kebundsc/solar_thermal_system/Doku/finalsolution.jpeg

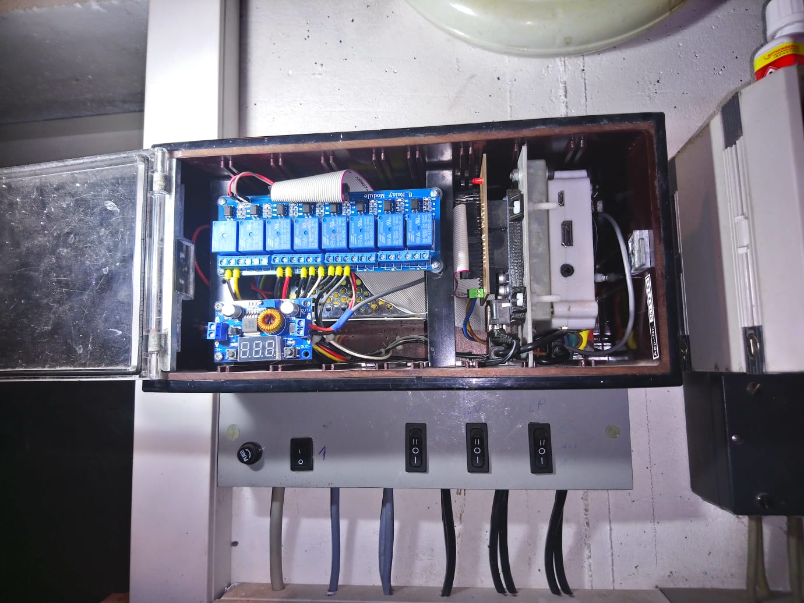
Doku/finalsolution.jpeg
