kebundsc/solar_thermal_system/ArduinoUNO/arduinoshield.jpeg

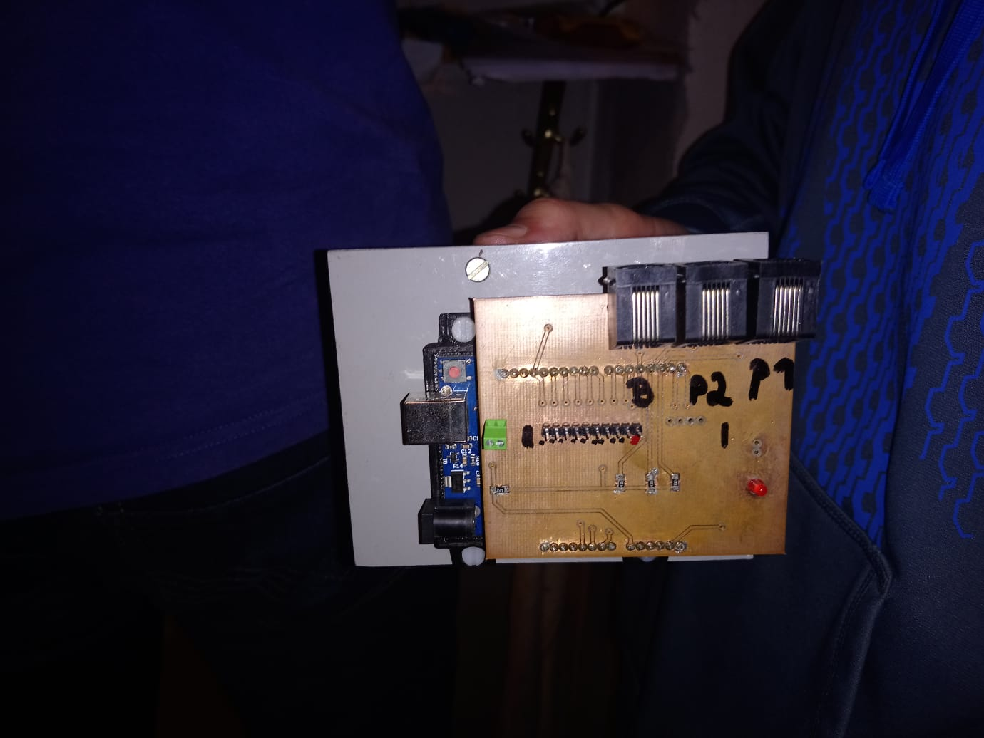
ArduinoUNO/arduinoshield.jpeg
