kebundsc/solar_thermal_system/Doku/solarthermalsystem_2018_19_MoCo.pdf

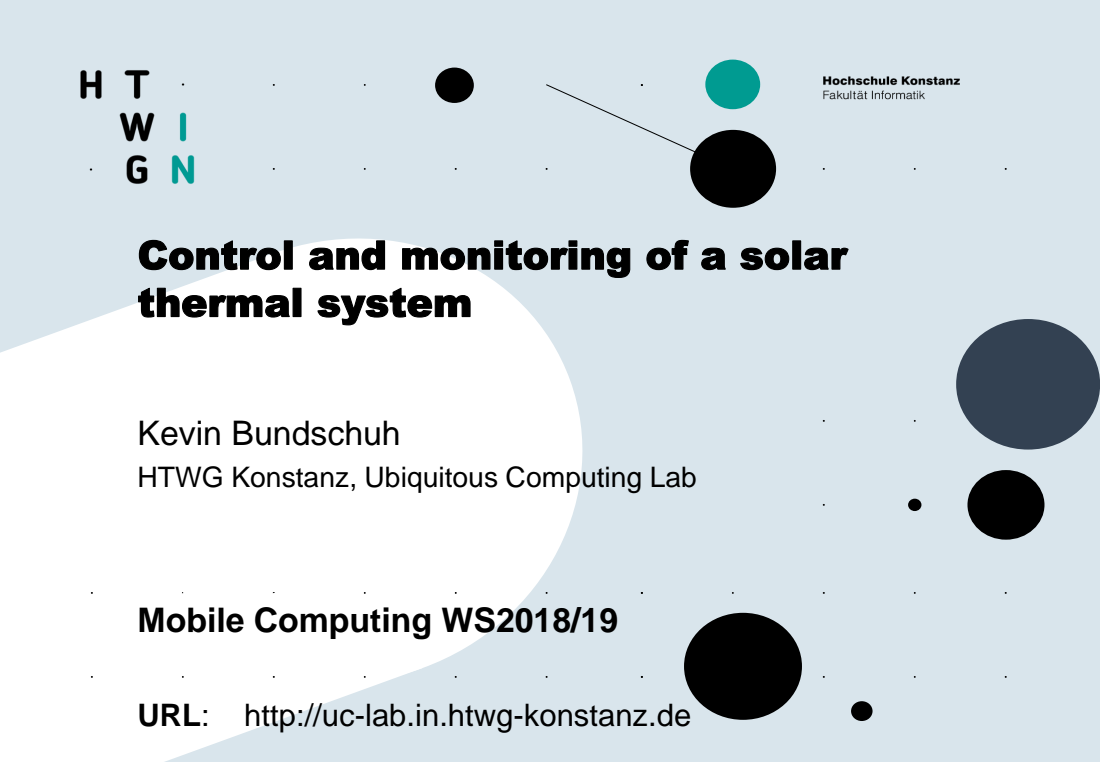
[picture p7: page 1]

Control and monitoring of a solar
thermal system

Kevin Bundschuh
HTWG Konstanz, Ubiquitous Computing Lab

Prof. Dr. Ralf E.D. Seepold
Mobile Computing WS2018/19

URL: http://uc-lab.in.htwg-konstanz.de

## Table of contents

- Introduction
- Project Targets
- Control Unit
- Hardware
- Software
- Monitoring System
- Final Solution
- Conclusion future Work
© Prof. Dr. Ralf E.D. Seepold | Ubiquitous Computing Lab | 2

## Introduction

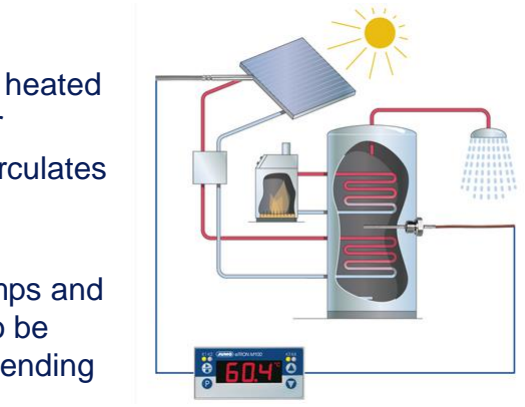
[picture p8: figure]

⚫ | Carrier fluid is heated up in Collector
⚫ | Carrier fluid circulates trough heat exchangers
⚫ | Therefore pumps and valves need to be controlled depending on meassured temperatures

http://www.jumo.nl/nl_NL/branches/Duurzame-energie/toepassingen/thermische-zonne-energie/solarthermie.html

## Project Targets


⚫ | Control Unit
| • reliable • low cost • easy to maintain
⚫ | Monitoring
| • Real time data • Data Archive • Compatibe with many different devices

## Control Unit → Hardware

- Arduino uno
- 8-Way Relais Module
- 6 x DS18B20 temperature sensors (1Wire)
- 1 x PT 1500 temperature sensor

0,65

0,7

0,75

0,8

0,85

0,9

0,95

1000 1100 1200 1300 1400 1500 1600 1700 1800 1900 2000 2100 2200 2300 2400 2500 2600 2700 2800 2900 3000

resistance

resistance

## Control Unit → Hardware

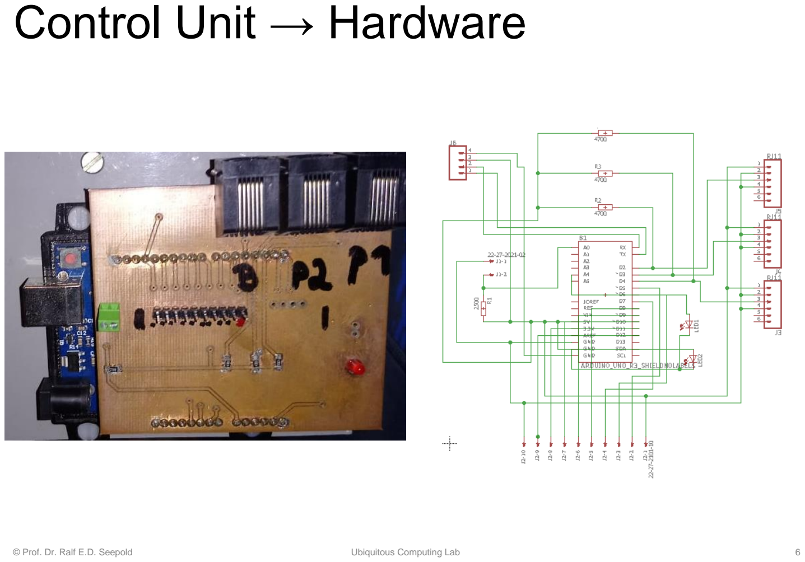
[picture p9: page 6]

## Control Unit → Software

- Arduino *.ino sketch
- Reading temperatures from 1Wire devices
- Calculating temperature from PTC
- Controling relais module via GPIOs
- Watchdog timer to increase reliablity
- Providing data over serial port

0

500

1000

1500

2000

2500

3000

3500

4000

0 | 10 | 20 | 25 | 30 | 40 | 50 | 60 | 70 | 80 | 90 | 100
Datenreihen1 | linear

r(x) = 18.74x + 1630

## Monitoring System → Architecture


⚫ | Software runing on the Raspberry PI
⚫ | Managing real time data and data archive

## Monitoring System → AMQP Broker

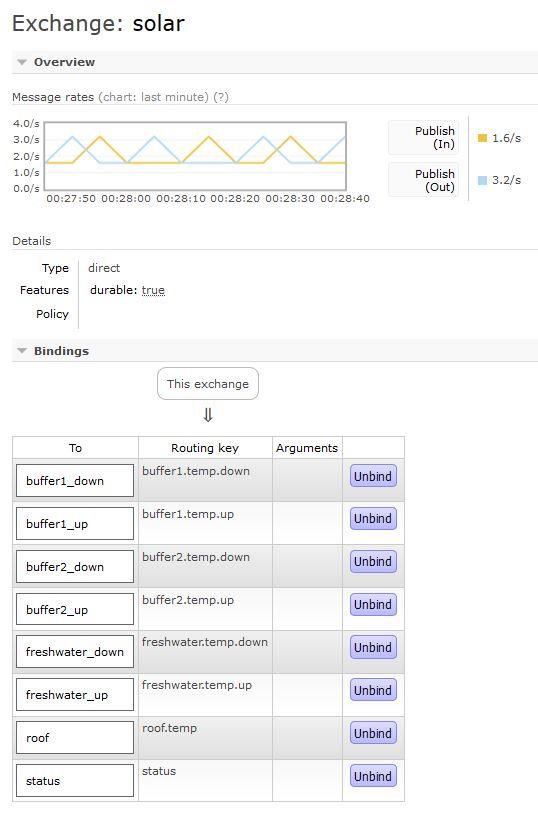
[picture p10: figure]

⚫ | Exchange has multiple bindigs to certain queues
⚫ | One queue for each temperature value and current status of the system

## Monitoring System → Node RED

- Is a programming tool for wiring together hardware devices, APIs and online services
- The runtime is built on Node.js
- Nodes for a live data dashboard

## Monitoring System → Node RED

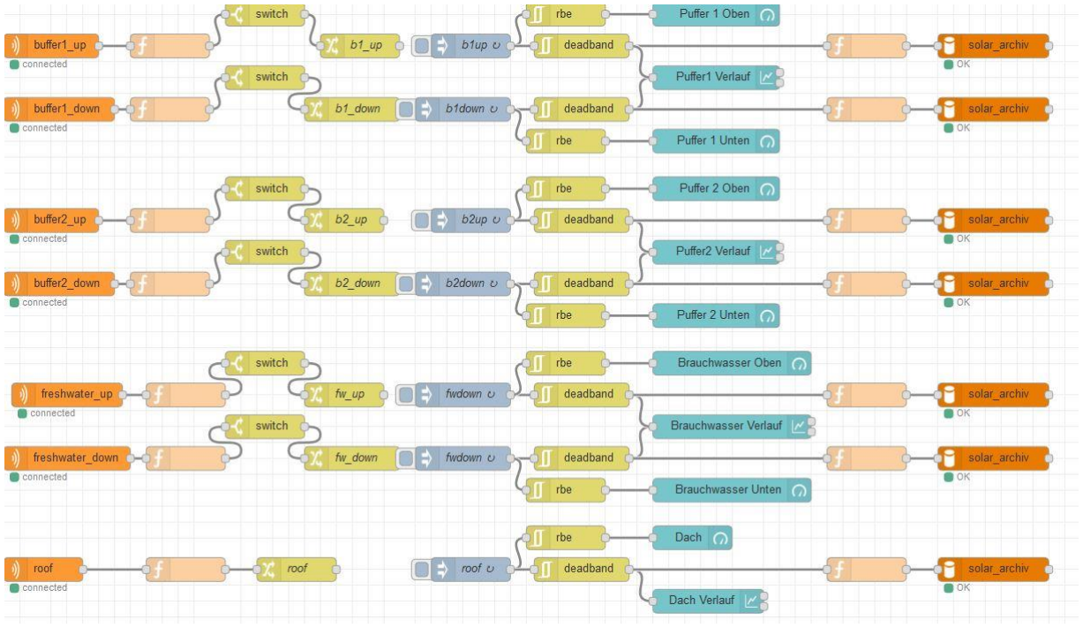
[picture p11: figure]

## Final Solution

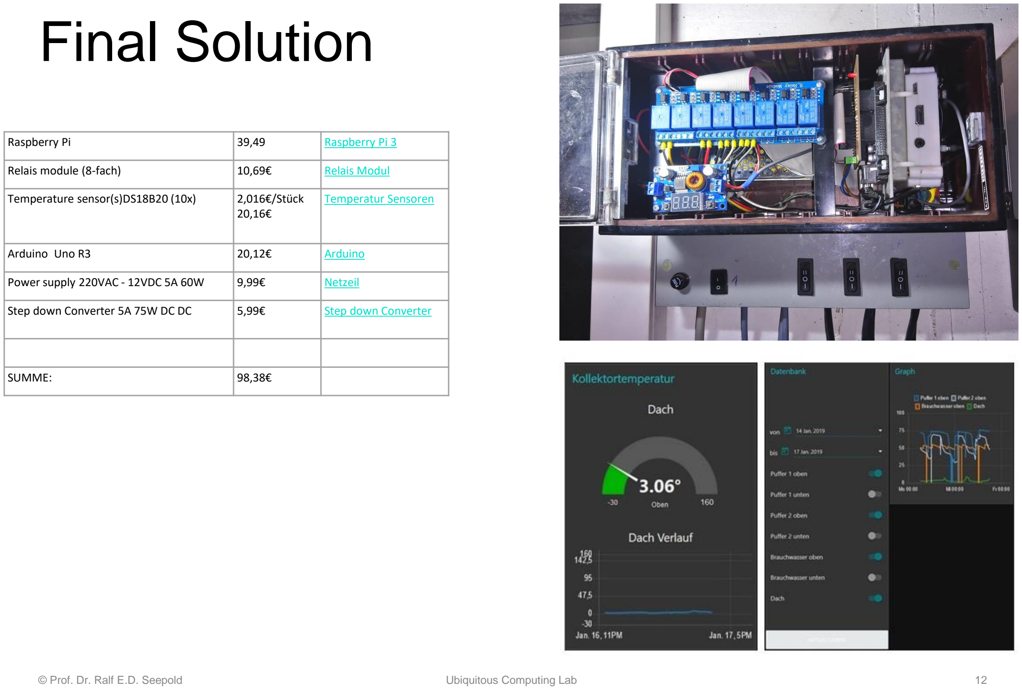
[picture p12: page 12]

Raspberry Pi | 39,49 | Raspberry Pi 3 (https://www.amazon.de/gp/product/B01CD5VC92/ref=oh_aui_detailpage_o04_s00?ie=UTF8&psc=1)
Relais module (8-fach) | 10,69€ | Relais Modul (https://www.amazon.de/Kuman-Shield-Module-Arduino-Raspberry/dp/B014L10Q52)
Temperature sensor(s)DS18B20 (10x) | 2,016€/Stück 20,16€ | Temperatur Sensoren (https://www.amazon.de/gp/product/B00CHEZ250/ref=oh_aui_detailpage_o04_s01?ie=UTF8&psc=1)
Arduino Uno R3 | 20,12€ | Arduino (https://www.amazon.de/gp/product/B008GRTSV6/ref=oh_aui_detailpage_o00_s00?ie=UTF8&psc=1)
Power supply 220VAC - 12VDC 5A 60W | 9,99€ | Netzeil (https://www.amazon.de/gp/product/B0191H4ST6/ref=oh_aui_detailpage_o01_s00?ie=UTF8&psc=1)
Step down Converter 5A 75W DC DC | 5,99€ | Step down Converter (https://www.amazon.de/gp/product/B01FRZVZPQ/ref=oh_aui_detailpage_o03_s00?ie=UTF8&psc=1)
SUMME: | 98,38€

## Conclusion Future Work

⚫ | System is now tested for several days without any failure
⚫ | Every target reached • Real time data • Data archive • <100€
⚫ | Email/sms alert in case of failure
⚫ | Controling system via dashboard
⚫ | Adjust regulation parameters for efficency

Thanks for your attention.

## Questions?

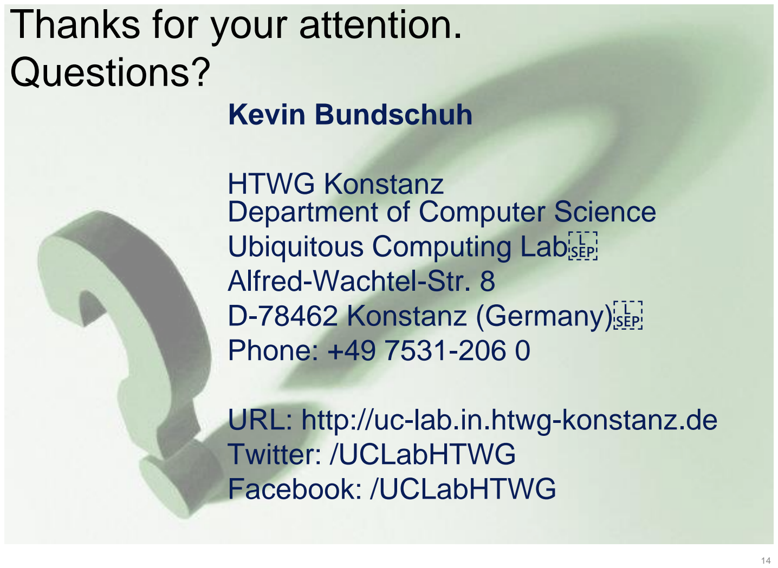
[picture p13: page 14]

14

Kevin Bundschuh

HTWG Konstanz
Department of Computer Science Ubiquitous Computing Lab
Alfred-Wachtel-Str. 8
D-78462 Konstanz (Germany) Phone: +49 7531-206 0

URL: http://uc-lab.in.htwg-konstanz.de Twitter: /UCLabHTWG
Facebook: /UCLabHTWG
