kebundsc/solar_thermal_system/RaspberryPI/interface_roof.JPG

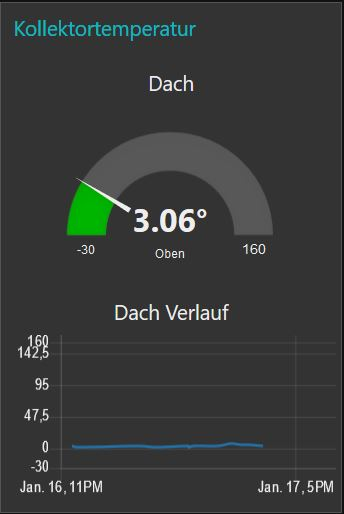
RaspberryPI/interface_roof.JPG
