kebundsc/solar_thermal_system/RaspberryPI/nodered_flow.JPG

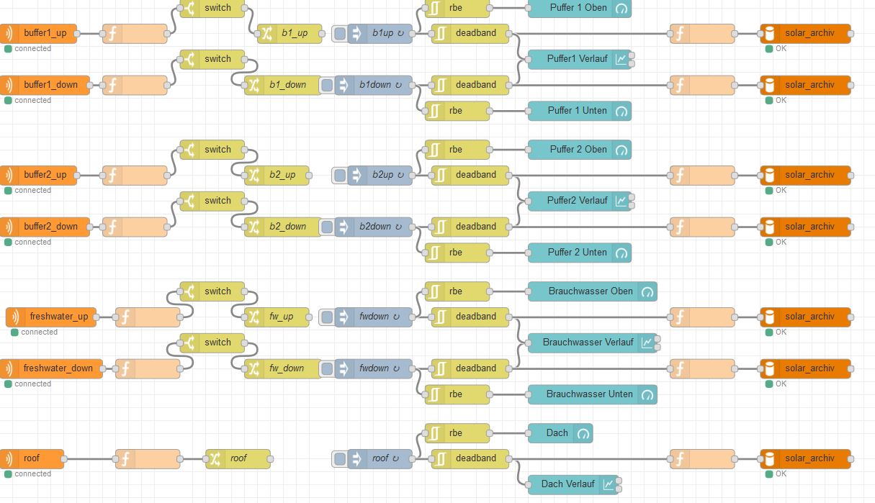
RaspberryPI/nodered_flow.JPG
