kebundsc/solar_thermal_system/PCB/untitled.brd

## EAGLE design PCB/untitled.brd (2019-01-24)

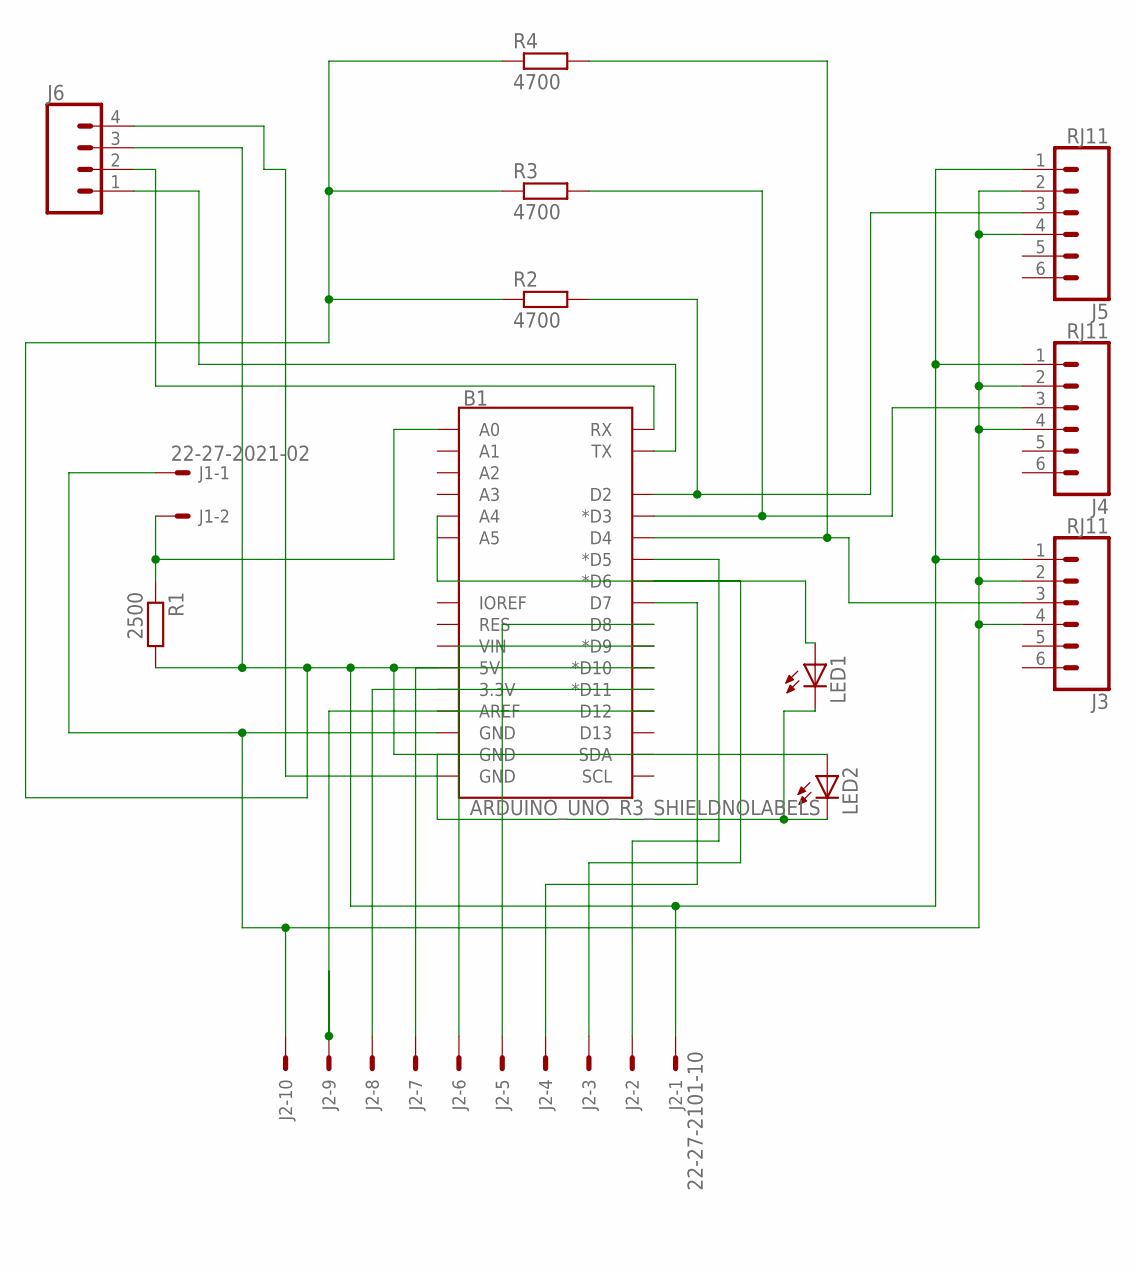
[picture p16: schematic untitled.sch]

Parts:
B1: ARDUINO_UNO_R3_SHIELDNOLABELS; UNO_R3_SHIELD_NOLABELS
J1: 22-27-2021-02; 6410-02
J2: 22-27-2101-10; 6410-10
J3, J4, J5: RJ11; RJ11-6
J6: CONN_04; 1X04
LED1, LED2: LED3MM
R1: 2500; R1206
R2, R3, R4: 4700; R1206

Connections:
unnamed: B1.5V, J2.1, J3.1, J4.1, J5.1, J6.3, LED2.A, R1.2, R2.1, R3.1, R4.1
unnamed: B1.GND@2 (GND), J1.1, J2.10, J3.2, J3.4, J4.2, J4.4, J5.2, J5.4
unnamed: B1.D12, J2.9
unnamed: B1.A0, J1.2, R1.1
unnamed: B1.D5 (*D5), J2.2
unnamed: B1.D6 (*D6), J2.3
unnamed: B1.D2, J5.3, R2.2
unnamed: B1.D3 (*D3), J4.3, R3.2
unnamed: B1.D4, J3.3, R4.2
unnamed: B1.D7, J2.4
unnamed: B1.D8, J2.5
unnamed: B1.D9 (*D9), J2.6
unnamed: B1.D10 (*D10), J2.7
unnamed: B1.D11 (*D11), J2.8
unnamed: B1.TX, J6.1
unnamed: B1.RX, J6.2
unnamed: B1.GND@0 (GND), J6.4
unnamed: B1.GND@1 (GND), LED1.K (C), LED2.K (C)
unnamed: B1.A4, LED1.A

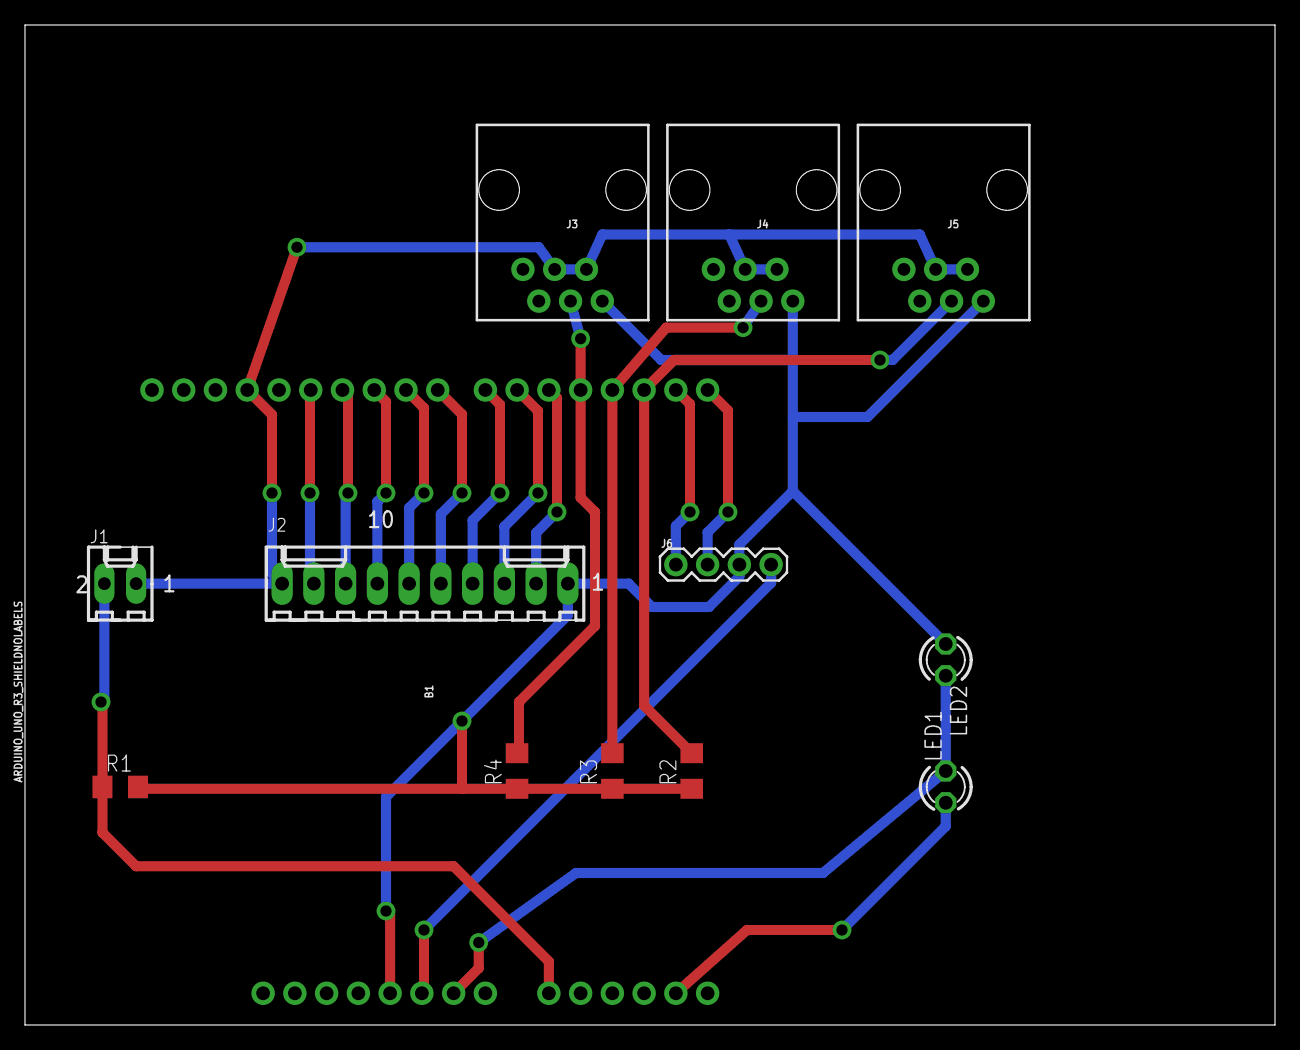
[picture p17: board untitled.brd from above]

Board: 2 copper layers, 100.0 x 80.0 mm, 13 parts (0 on the bottom side), 19 nets.
